dan-leo/thesis/README.md

# thesis
B.Eng (Hons) thesis, Stellenbosch University
