dan-leo/thesis/.latex/thesis.tex

% !TEX program = pdflatex
% !BIB program = biber

%% One can optionally have all this inside a separate setup.tex
\include{setup}

\title{Insert title here}
\author{Daniel Robinson\\18361137}

\pagenumbering{roman}
\setlength\parindent{0pt}

\begin{document}
% \maketitle
    \begin{titlepage}
        \begin{center}
            \vspace*{1cm}
            
            \begin{figure}
			\centering
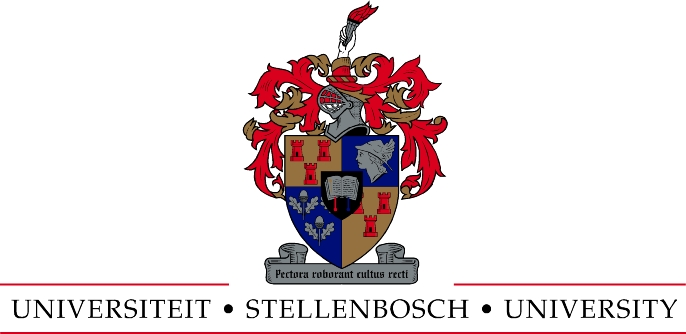
[picture p1: .latex/images/UScrest-top.jpg]
            
            \end{figure}
            
            \huge
            \textbf{Normalized Differential Vegetation Index Mapping}

            \large            
            \vspace{2.5cm}

            \textbf{Daniel Robinson\\18361137}

            \vspace{2.5cm}    
            
            \textbf{Report submitted in partial fulfilment of the requirements of the module Project (E) 448
            for the degree Baccalaureus in Engineering in the Department of Electrical and Electronic
            Engineering at the University of Stellenbosch}
            
            \vspace{4cm} 
            
            \textbf{STUDY LEADER: Corné van Daalen\\DATE: November 2017}

        \end{center}
\end{titlepage}

\setcounter{secnumdepth}{-2}% default for "report" is 2

\newpage
\chapter{Declaration of own work}

I, the undersigned, hereby declare that the work contained in this report is my own original work
unless indicated otherwise.

\vspace{2.5cm}   

Signature: \hrulefill

\hspace*{0mm}\phantom{Signature: }Daniel Robinson

\hspace*{0mm}\phantom{Signature: }BEng Electrical \& Electronic

\vspace{1cm}   

Date:\space\space\space\space\space\hrulefill

\chapter{Abstract}

This report presents the design and analysis necessary for an autonomous system to acquire beneficial agricultural data within a desired environment.\\

Various implementations are compared, before a novel design is presented.\\

An aerial drone is designed and built using predominantly local supplies. Images are acquired, calibrated, processed and mapped before an NDVI is performed. The system is quite capable and cost-effective compared to existing solutions. However, further investigation is required in mapping and NDVI calibration for consistency.

\chapter{Uitreksel}

Hierdie verslag toon die nodige ontwerp en ontleding aan om nuttige landbou data van 'n uitverkose omgewing deur middel van 'n selfbesturende sisteem te verkry.\\

Verskye toepassings is met mekaar vergelyk voordat 'n unieke ontwerp aangebied is.\\

'n Onbemande hommeltuig is ontwerp en gebou deur hoofsaaklik van plaaslike onderdele gebruik te maak. In die proses is foto's verkry, gekalibreer, verwerk en gekarteer voordat 'n genormaliseerde differensiële plantegroei indeks (GDPI) bereken is. Die stelsel is geskik en koste effektief in vergelyking met huidige komersiële oplossings.\\

Vir konsekwensie word verdere ondersoek egter in kartering en kalibrasie van die GDPI verlang.

\chapter{Acknowledgements}

I would like to thank the following people for their support:
\begin{itemize}
    \item Louw Hopley, for giving birth to the idea.
    \item Alan Knott-Craig, for introducing me to Chris Antoniesson, for we went on a flight test together which returned very useful data.
    \item My family, who have been amused and for their unwavering love and support.
    \item Dr Corné van Daalen, for his guidance and support throughout the course of this project.
\end{itemize}

%\frontmatter
\cleardoublepage
\tableofcontents

\clearpage
\label{listoffigures}
\addcontentsline{toc}{chapter}{\listfigurename}
\listoffigures

%\clearpage
%\addcontentsline{toc}{chapter}{\listtablename}
%\label{listoftables}
%\listoftables

%\chapter{List of Symbols}
%\begin{table}[H]
%\centering
%\begin{tabular}{l|r|r}
%Symbol & Description & Units\\\hline\\
%$F$ & Fundamenal Matrix & 3x3\\
%$R$ & Rotation Matrix & 3x3\\
%$T$ & Translation Matrix & 3x3\\
%\end{tabular}
%%\caption{\label{tab:symb}Table depicting list of symbols. (Will probably not have this caption)}
%\end{table}

\chapter{List of Abbreviations}
\begin{table}[H]
\centering
\begin{tabular}{l|r}
Abbreviation & Description \\\hline
UAV & Unmanned Aerial Vehicle \\
NDVI & Normalised Differential Vegetation Index\\
IR & Infra Red\\
PAR & Photosynthetically Active Radiation\\
PCB & Printed Circuit Board\\
CSI & Camera Serial Interface\\
SBUS & Serial Bus\\
GPIO & General Purpose In Out\\
LUT & Look Up Table\\
FHSS & Frequency Hopping Spread Spectrum\\
NLOS & Non Line of Sight\\
SDR & Software Defined Radio\\
GPS & Global Positioning System\\
MME & Maps Made Easy\\
RGB & Red Green Blue\\
NIR & Near Infra Red\\
ESC & Electronic Speed Controller\\
PPM & Pulse Position Modulation\\
ISM & Industrial Scientific Medical\\
IMU & Inertial Measurement Unit\\
SMA & SubMiniature version A\\
GCS & Ground Control Station\\
PWM & Pulse Width Modulation\\
SDR & Software Defined Radio\\
NTP & Network Time Protocol\\

\end{tabular}
%\caption{\label{tab:abbr}Table depicting list of abbreviations. (Will probably not have this caption)}
\end{table}

%\chapter{Matrix Notation}
%
%(Still to be expanded on).

\setcounter{secnumdepth}{2}

\include{chapter1}
\label{chapter:intro}
\include{chapter2}
\label{chapter:literature}
\include{chapter3}
\include{chapter4}
\include{chapter5}
\include{chapter6}

\chapter{Conclusion}

Overall, the system seems capable. It is much cheaper than equivalent products on the market today, and would require some refining to be robust, and consistently useful for farmers.\\

The drone design and construction, image acquisition, stereo rectification and calibration was a success, but the mapping and NDVI calibration will need some further investigation.\\

With further investigation, it can be determined whether farmers are applying water, fertilizer and pesticides uniformly, and the effects of other environmental factors.\\

% In order for the data to be transmitted successfully, it needs to be in a format acceptable by the GCS. The data will be stored in a JSON packet created using a C++ library\cite{ajson}.

% Code block \ref{code:json1} shows a potential data packet.

% \lstset{language=html,caption={Potential packet},label=code:json1}
% \begin{lstlisting}
% {
%   "temperature": "11.3",
%   "pressure": "99.325"
% }
% \end{lstlisting}

% \begin{figure}
% \centering
% \includegraphics[scale=0.35]{flight_path.png}
% \caption{CanSat flight trajectory\\
% Reproduced from \cite{gopher}}
% \label{fig:flight_path}
% \end{figure}

% \subsection{How to add Tables}

% Use the table and tabular commands for basic tables --- see Table~\ref{tab:widgets}, for example. 

% \begin{table}
% \centering
% \begin{tabular}{l|r}
% Item & Quantity \\\hline
% Widgets & 42 \\
% Gadgets & 13
% \end{tabular}
% \caption{\label{tab:widgets}An example table.}
% \end{table}

% \subsection{How to write Mathematics}

% \LaTeX{} is great at typesetting mathematics. Let $X_1, X_2, \ldots, X_n$ be a sequence of independent and identically distributed random variables with $\text{E}[X_i] = \mu$ and $\text{Var}[X_i] = \sigma^2 < \infty$, and let
% \[S_n = \frac{X_1 + X_2 + \cdots + X_n}{n}
%       = \frac{1}{n}\sum_{i}^{n} X_i\]
% denote their mean. Then as $n$ approaches infinity, the random variables $\sqrt{n}(S_n - \mu)$ converge in distribution to a normal $\mathcal{N}(0, \sigma^2)$.

% \subsection{How to create Sections and Subsections}

% Use section and subsections to organize your document. Simply use the section and subsection buttons in the toolbar to create them, and we'll handle all the formatting and numbering automatically.

% \subsection{How to add Lists}

% You can make lists with automatic numbering \dots

% \begin{enumerate}
% \item Like this,
% \item and like this.
% \end{enumerate}
% \dots or bullet points \dots
% \begin{itemize}
% \item Like this,
% \item and like this.
% \end{itemize}

% \subsection{How to add Citations and a References List}

% You can upload a \verb|.bib| file containing your BibTeX entries, created with JabRef; or import your \href{https://www.overleaf.com/blog/184}{Mendeley}, CiteULike or Zotero library as a \verb|.bib| file. You can then cite entries from it, like this: \cite{greenwade93}. Just remember to specify a bibliography style, as well as the filename of the \verb|.bib|.

% You can find a \href{https://www.overleaf.com/help/97-how-to-include-a-bibliography-using-bibtex}{video tutorial here} to learn more about BibTeX.

% We hope you find Overleaf useful, and please let us know if you have any feedback using the help menu above --- or use the contact form at \url{https://www.overleaf.com/contact}!

\include{appendices}

\newpage
\bibliographystyle{plain}
%\bibliographystyle{alpha}
\bibliography{references}

%@misc{gopher,
%	author = {Garden City Collegiate Space Agency},
%    title = {GOPHER SPACE},
%    month = feb,
%    year = {2017},
%    howpublished={\url{http://gopherspace.pbworks.com/w/page/93541286/GOPHER%20SPACE}}
%}
%
%@article{greenwade93,
%    author  = "George D. Greenwade",
%    title   = "The {C}omprehensive {T}ex {A}rchive {N}etwork ({CTAN})",
%    year    = "1993",
%    journal = "TUGBoat",
%    volume  = "14",
%    number  = "3",
%    pages   = "342--351"
%}

\end{document}
