dan-leo/thesis/.latex/main.tex

% !TEX program = pdflatex
% !BIB program = biber

%% One can optionally have all this inside a separate setup.tex
\include{setup}

\title{Insert title here}
\author{Daniel Robinson\\18361137}

\begin{document}
% \maketitle
    \begin{titlepage}
        \begin{center}
            \vspace*{1cm}
            
            \begin{figure}
			\centering
            
            \end{figure}
            
            \huge
            \textbf{Insert title here\\Sub-title}
            
            \vspace{1.5cm}
            
            \large
            \vspace{2.5cm}
            Daniel Robinson\\
            18361137\\
            \vspace{4.5cm}
            
            \large
            Date: 7 February 2017
            
        \end{center}
\end{titlepage}

\tableofcontents
\listoffigures
\listoftables

\newpage

% \begin{abstract}
% Your abstract.
% \end{abstract}

\section{Systems Overview}

In this section the mission objectives and requirements are specified.

\subsection{Mission Objectives}
In order to be deemed successful the CanSat system needs to complete the following missions:

\begin{itemize}
    \item The CanSat will be launched from approximately 1000m by a rocket.  The CanSat will then be ejected from the rocket.
    \item Measurements of air pressure and temperature will be taken during decent.
    \item These measurements will be transmitted at least once every second to the ground station.
    \item On the ground station the received data will be analysed.
\end{itemize}

% \begin{figure}[H]
% \begin{subfigure}{0.5\textwidth}
% \includegraphics[scale=0.3]{3.png}
% \caption{Pushbutton Switch.\\
% Reproduced from \cite{cpi}.}
% \label{fig:p}
% \end{subfigure}
% \begin{subfigure}{0.5\textwidth}
% \centering
% \includegraphics[scale=0.1]{2.png}
% \caption{InvenSense MPU-9250.\\
% Reproduced from\cite{iven}.}
% \label{fig:att}
% \end{subfigure}
% \begin{subfigure}{0.5\textwidth}
% \centering
% \includegraphics[scale=0.3]{1.png}
% \caption{Altimeter Module MS5607.\\ Reproduced from \cite{par}.}
% \label{fig:pres}
% \end{subfigure}
% \caption{Sensors}
% \label{fig:sensors}
% \end{figure}

% In order for the data to be transmitted successfully, it needs to be in a format acceptable by the GCS. The data will be stored in a JSON packet created using a C++ library\cite{ajson}.

% Code block \ref{code:json1} shows a potential data packet.

% \lstset{language=html,caption={Potential packet},label=code:json1}
% \begin{lstlisting}
% {
%   "temperature": "11.3",
%   "pressure": "99.325"
% }
% \end{lstlisting}

% \begin{figure}
% \centering
% \includegraphics[scale=0.35]{flight_path.png}
% \caption{CanSat flight trajectory\\
% Reproduced from \cite{gopher}}
% \label{fig:flight_path}
% \end{figure}

% \subsection{How to add Tables}

% Use the table and tabular commands for basic tables --- see Table~\ref{tab:widgets}, for example. 

% \begin{table}
% \centering
% \begin{tabular}{l|r}
% Item & Quantity \\\hline
% Widgets & 42 \\
% Gadgets & 13
% \end{tabular}
% \caption{\label{tab:widgets}An example table.}
% \end{table}

% \subsection{How to write Mathematics}

% \LaTeX{} is great at typesetting mathematics. Let $X_1, X_2, \ldots, X_n$ be a sequence of independent and identically distributed random variables with $\text{E}[X_i] = \mu$ and $\text{Var}[X_i] = \sigma^2 < \infty$, and let
% \[S_n = \frac{X_1 + X_2 + \cdots + X_n}{n}
%       = \frac{1}{n}\sum_{i}^{n} X_i\]
% denote their mean. Then as $n$ approaches infinity, the random variables $\sqrt{n}(S_n - \mu)$ converge in distribution to a normal $\mathcal{N}(0, \sigma^2)$.

% \subsection{How to create Sections and Subsections}

% Use section and subsections to organize your document. Simply use the section and subsection buttons in the toolbar to create them, and we'll handle all the formatting and numbering automatically.

% \subsection{How to add Lists}

% You can make lists with automatic numbering \dots

% \begin{enumerate}
% \item Like this,
% \item and like this.
% \end{enumerate}
% \dots or bullet points \dots
% \begin{itemize}
% \item Like this,
% \item and like this.
% \end{itemize}

% \subsection{How to add Citations and a References List}

% You can upload a \verb|.bib| file containing your BibTeX entries, created with JabRef; or import your \href{https://www.overleaf.com/blog/184}{Mendeley}, CiteULike or Zotero library as a \verb|.bib| file. You can then cite entries from it, like this: \cite{greenwade93}. Just remember to specify a bibliography style, as well as the filename of the \verb|.bib|.

% You can find a \href{https://www.overleaf.com/help/97-how-to-include-a-bibliography-using-bibtex}{video tutorial here} to learn more about BibTeX.

% We hope you find Overleaf useful, and please let us know if you have any feedback using the help menu above --- or use the contact form at \url{https://www.overleaf.com/contact}!

\newpage
\bibliographystyle{plain}
% \bibliographystyle{alpha}
\bibliography{references}

\end{document}
