dan-leo/thesis/.latex/images/base_eagle.JPG

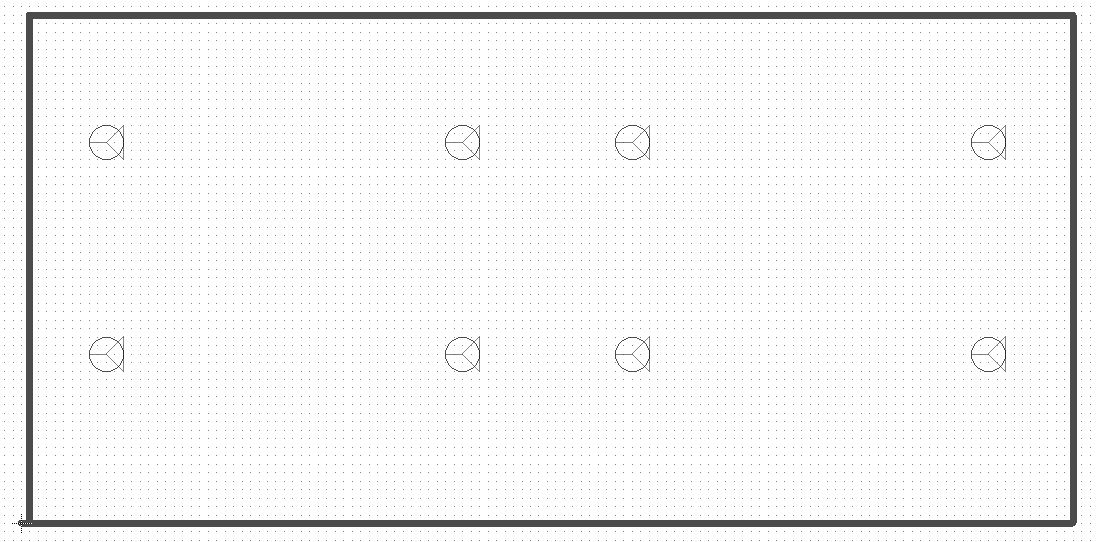
.latex/images/base_eagle.JPG
