dan-leo/thesis/.latex/images/distortion_flir2.JPG

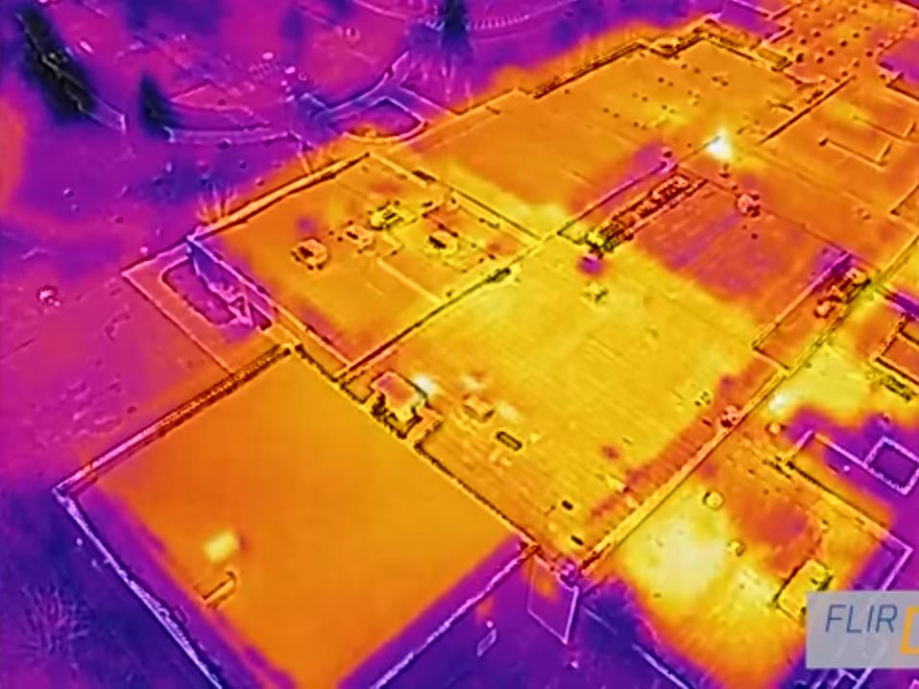
.latex/images/distortion_flir2.JPG
