dan-leo/thesis/.latex/images/distortion_flir.JPG

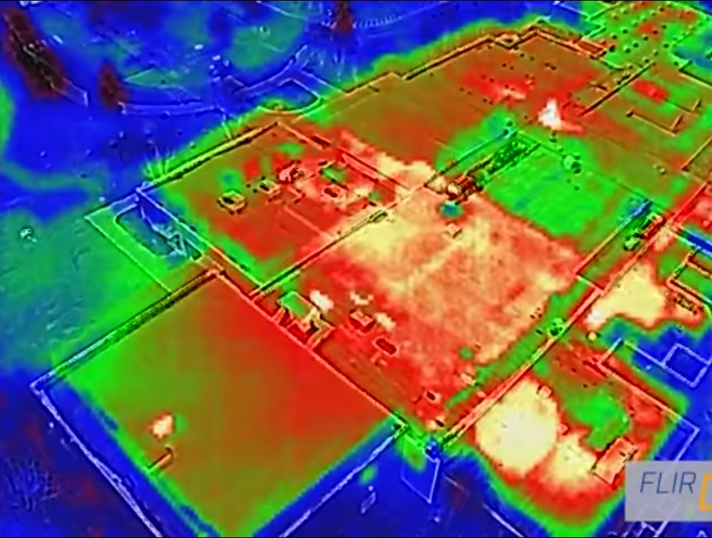
.latex/images/distortion_flir.JPG
