dan-leo/thesis/.latex/images/hex.JPG

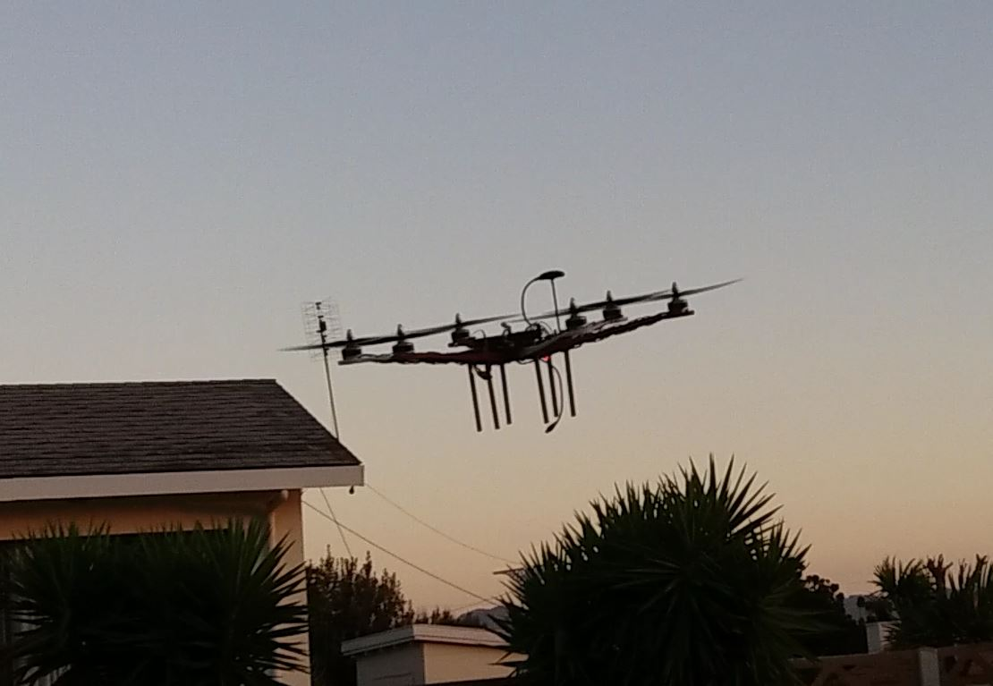
.latex/images/hex.JPG
