dan-leo/thesis/.latex/images/lcd/20171028_095547.jpg

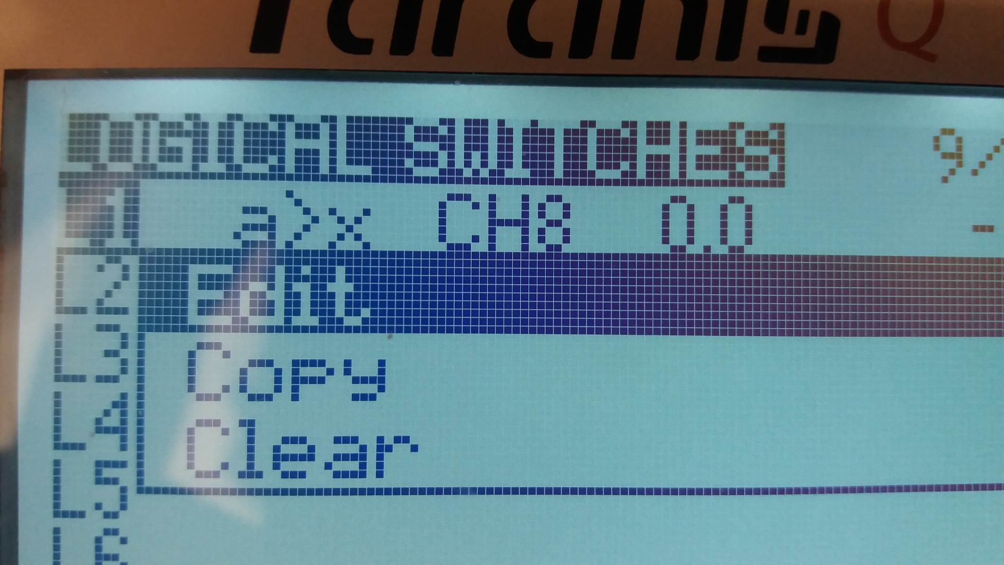
.latex/images/lcd/20171028_095547.jpg
