dan-leo/thesis/.latex/images/lcd/20171028_095605.jpg

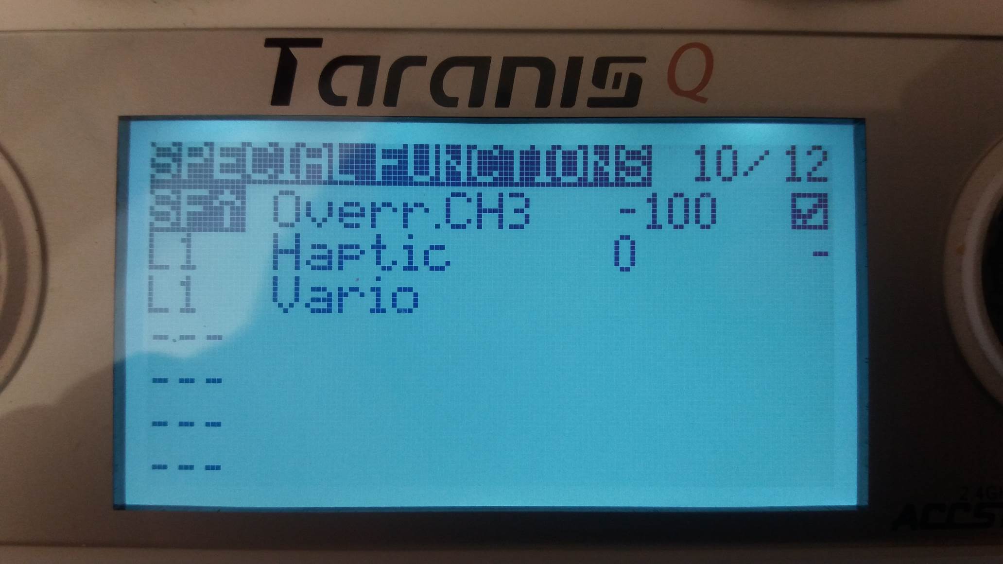
.latex/images/lcd/20171028_095605.jpg
