dan-leo/thesis/.latex/images/lcd/firmware.jpg

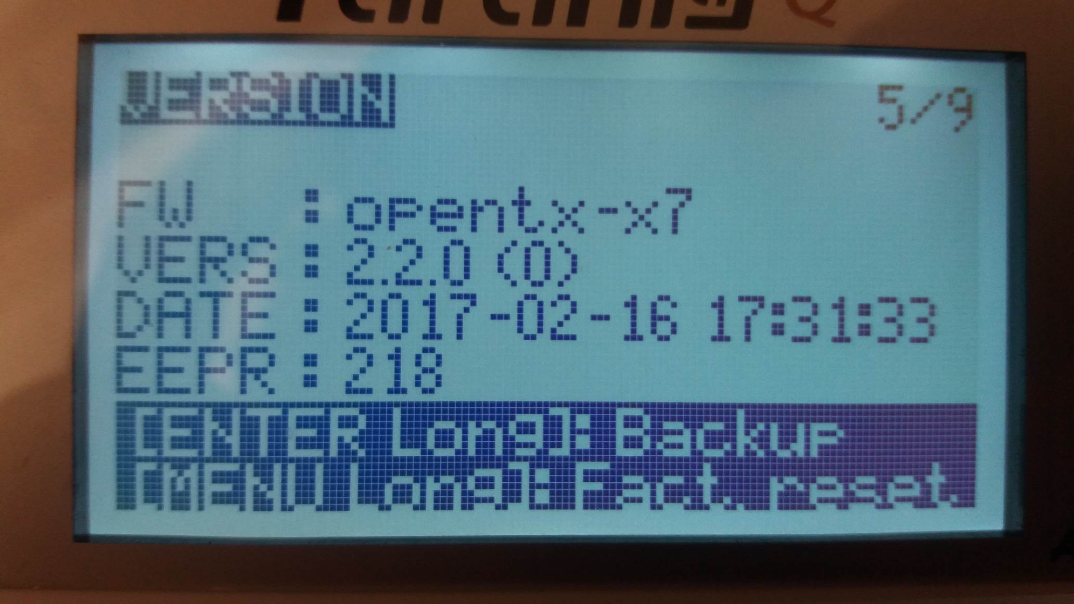
.latex/images/lcd/firmware.jpg
