dan-leo/thesis/.latex/images/lcd/mixer2.jpg

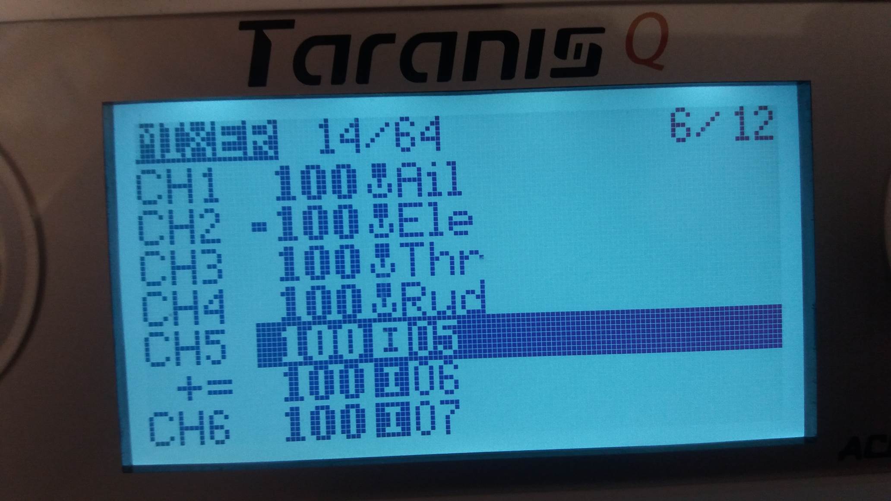
.latex/images/lcd/mixer2.jpg
