dan-leo/thesis/.latex/images/lcd/telemetry2.jpg

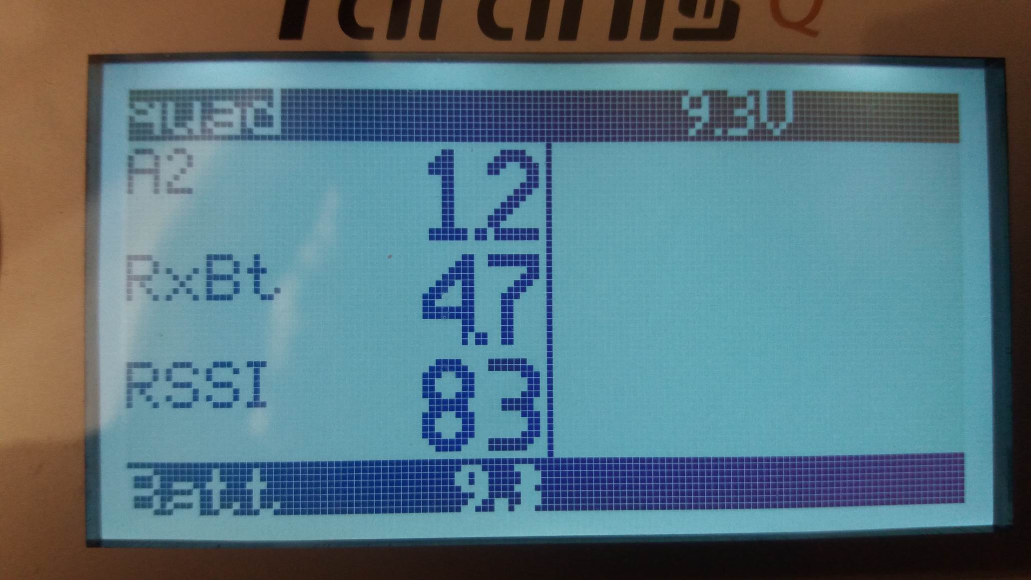
.latex/images/lcd/telemetry2.jpg
