dan-leo/thesis/.latex/images/ndvi_stitch_example.jpg

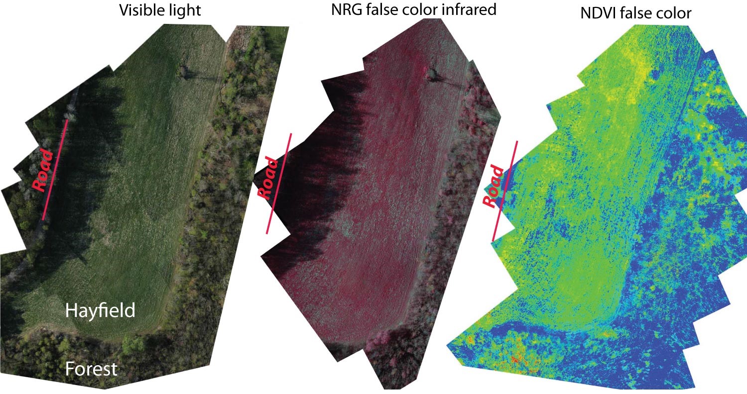
.latex/images/ndvi_stitch_example.jpg
