dan-leo/thesis/.latex/images/temp2/433_comms.PNG

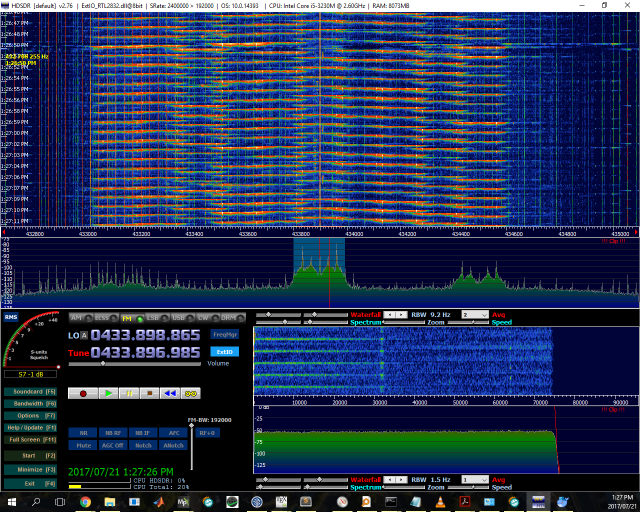
.latex/images/temp2/433_comms.PNG
