dan-leo/thesis/.latex/images/temp2/20170922_204751.jpg

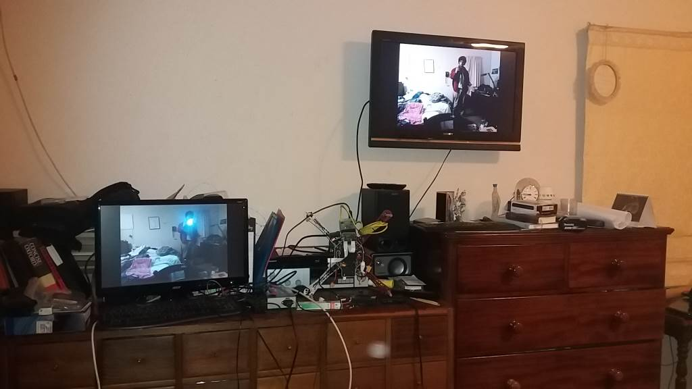
.latex/images/temp2/20170922_204751.jpg
