dan-leo/thesis/.latex/images/temp2/20171028_115440.jpg

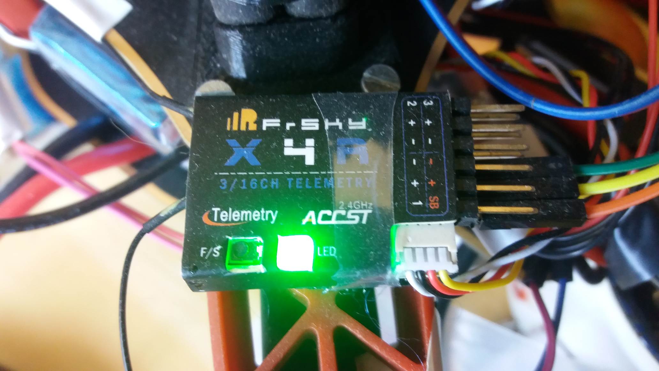
.latex/images/temp2/20171028_115440.jpg
