dan-leo/thesis/.latex/images/temp2/20171029_143333.jpg

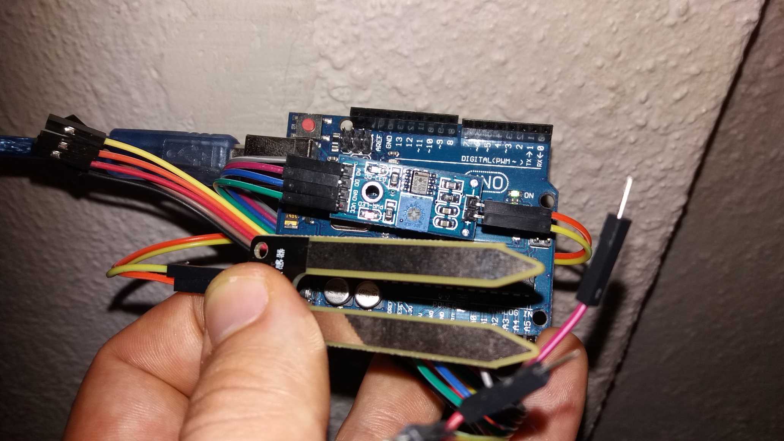
.latex/images/temp2/20171029_143333.jpg
