dan-leo/thesis/.latex/images/temp2/20171029_143347.jpg

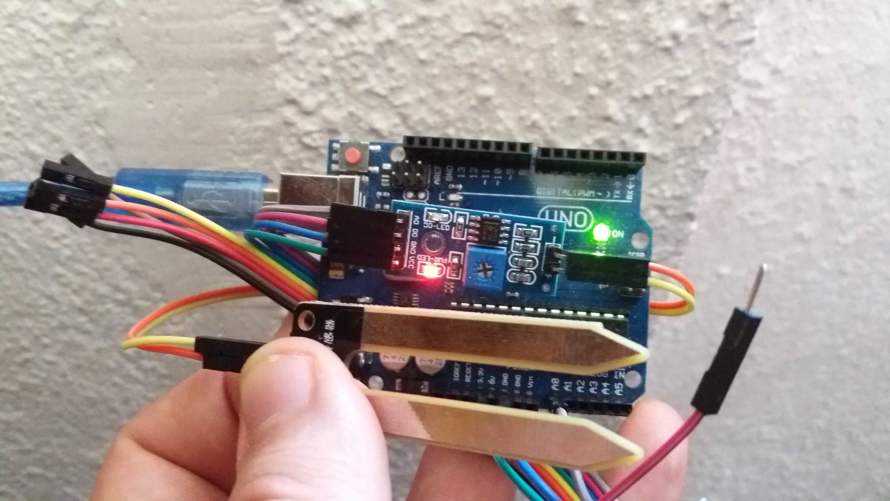
.latex/images/temp2/20171029_143347.jpg
