dan-leo/thesis/.latex/images/temp2/aluminium.jpg

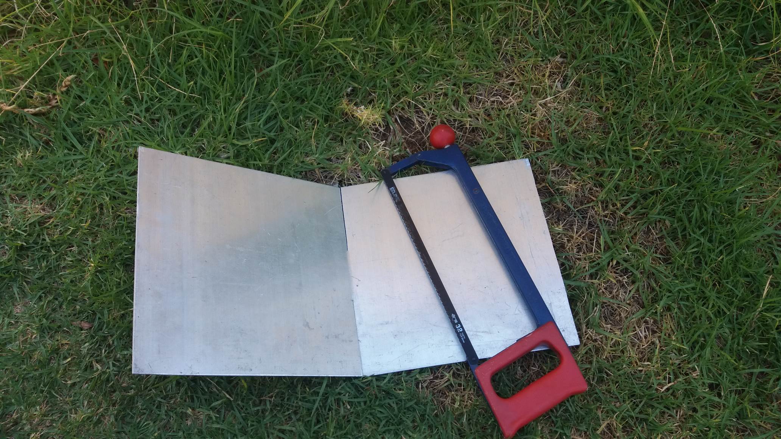
.latex/images/temp2/aluminium.jpg
