dan-leo/thesis/.latex/images/temp2/comp_mot_true_current.PNG

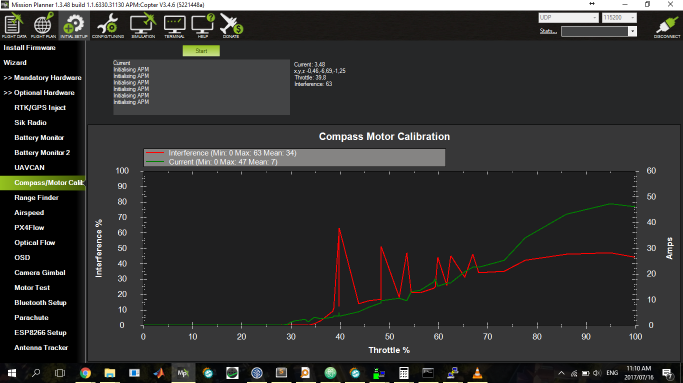
.latex/images/temp2/comp_mot_true_current.PNG
