dan-leo/thesis/.latex/images/temp2/flight_modes.JPG

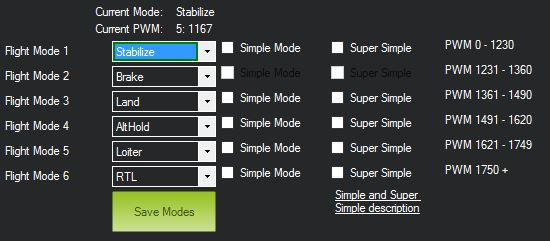
.latex/images/temp2/flight_modes.JPG
