dan-leo/thesis/.latex/images/temp2/longridgeir20171029.jpg

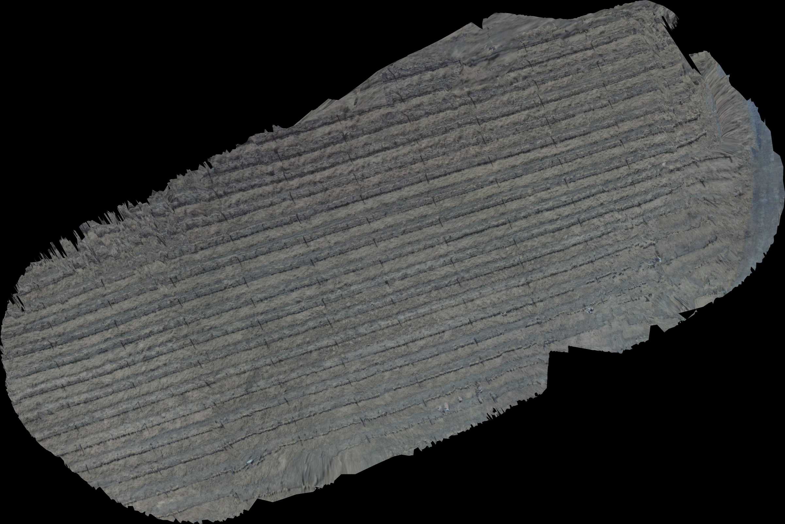
.latex/images/temp2/longridgeir20171029.jpg
