dan-leo/thesis/.latex/images/temp2/longridgergb20171029.jpg

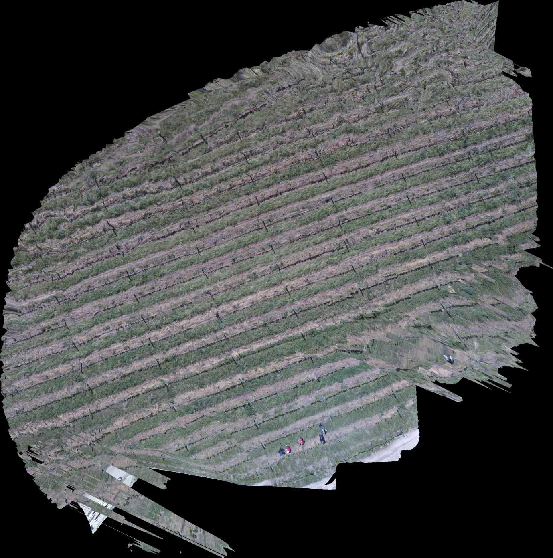
.latex/images/temp2/longridgergb20171029.jpg
