dan-leo/thesis/.latex/images/temp2/map_ndvi.jpg

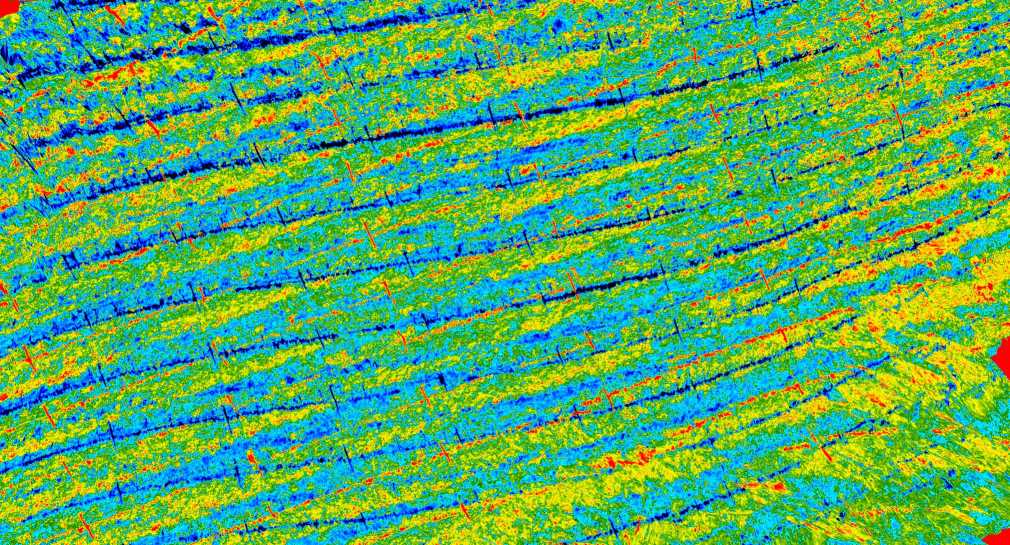
.latex/images/temp2/map_ndvi.jpg
