dan-leo/thesis/.latex/images/temp2/plane.jpg

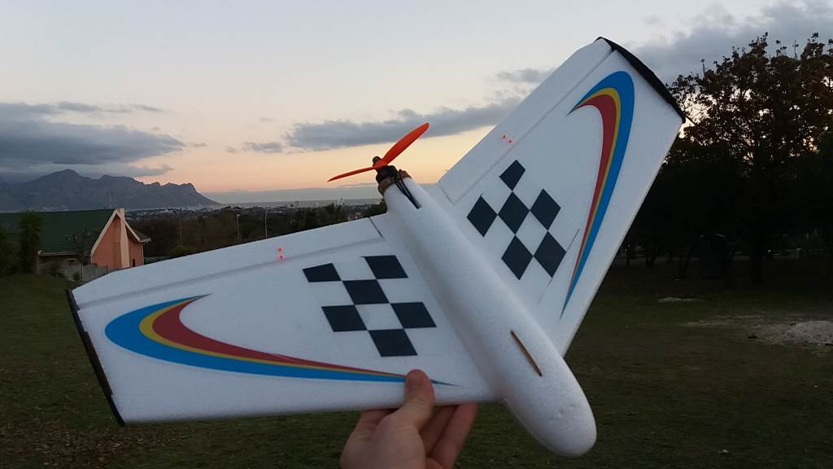
.latex/images/temp2/plane.jpg
