dan-leo/thesis/.latex/images/temp2/rgb2016-12-28-173739-147.jpg

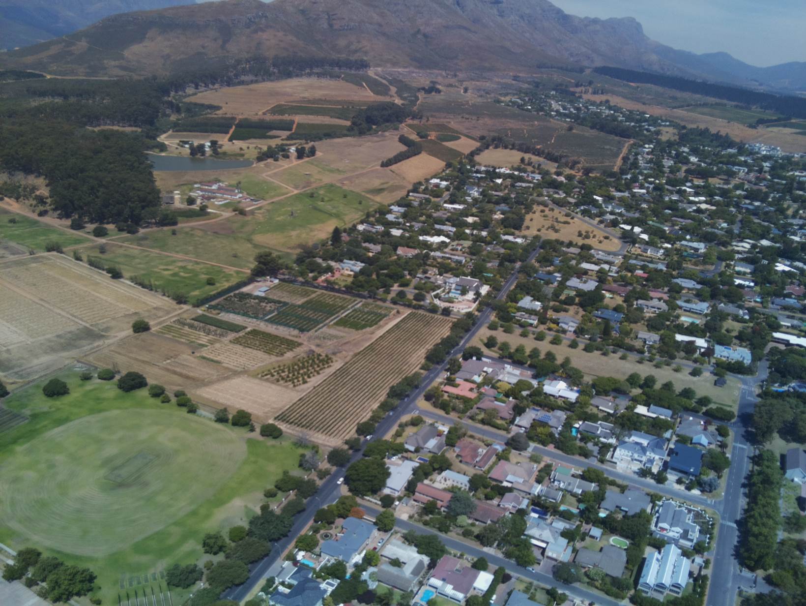
.latex/images/temp2/rgb2016-12-28-173739-147.jpg
