dan-leo/thesis/.latex/images/thesis_overview.png

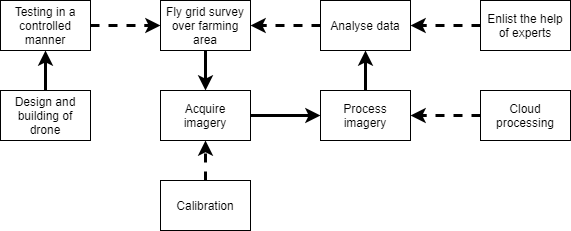
.latex/images/thesis_overview.png
