dan-leo/thesis/.latex/setup.tex

% !TEX program = pdflatex
% !BIB program = biber

% !TEX root = main.tex
\documentclass[12pt, a4paper]{report}
% \documentclass[12pt, a4paper, oneside]{memoir}
% \chapterstyle{veelo}

%% Sets page size and margins
\usepackage[a4paper,top=2.5cm,bottom=2cm,left=3cm,right=2cm,marginparwidth=1.75cm]{geometry}
%\usepackage[left=2cm,top=2cm,bottom=2cm,bindingoffset=1cm]{geometry}

\usepackage[utf8x]{inputenc}
\usepackage{graphicx}
\usepackage{float}
\usepackage{imakeidx}
\usepackage{amsmath}
\usepackage[colorlinks=true, allcolors=blue]{hyperref}
\usepackage{graphicx}
\usepackage{float}
\usepackage{imakeidx}
\usepackage{amsmath}
\usepackage{url}
\usepackage[export]{adjustbox}
\usepackage{subcaption}
\usepackage[toc,page]{appendix}
\usepackage{amsmath}
%\usepackage{nccmath}

%% Useful packages
\usepackage[colorinlistoftodos]{todonotes}
\usepackage[T1]{fontenc}

%% Language and font encodings
\usepackage[english]{babel}

%% Define a few colours to be used throughout the document
\usepackage{tikz,xcolor}
\definecolor{TextColor}{HTML}{000000}
\definecolor{SideColorDark}{HTML}{000000}
\definecolor{MainColor}{HTML}{0000FF}
\definecolor{OppositeColor}{HTML}{FF0000}
\definecolor{HighlightColor}{HTML}{FFFF00}

%% Code block style
%  Load the \ttfamily font
\usepackage[T1]{fontenc}
\usepackage[scaled]{beramono}

%  Format code blocks
\usepackage{listings}
%  Change caption name
\renewcommand*{\lstlistingname}{Code block}
\captionsetup[lstlisting]{margin=0cm,format=hang,font=small,format=plain,labelfont={bf,up},textfont={it}}
%  Style
\lstset{
  showstringspaces=false,
  formfeed=\newpage,
  commentstyle=\itshape,
  backgroundcolor=\color{gray!5},
  breakatwhitespace=false,         % sets if automatic breaks should only happen at whitespace
  breaklines=true,                 % sets automatic line breaking
  captionpos=b,                    % sets the caption-position to bottom
  commentstyle=\color{gray},    % comment style
  escapeinside={\%*}{*)},          % if you want to add LaTeX within your code
  keepspaces=true,
  numbersep=2mm,                   % how far the line-numbers are from the code
  showspaces=false,
  showstringspaces=false,
  showtabs=false,
  stepnumber=1, numberfirstline=false,
  basicstyle=\linespread{1}\footnotesize\ttfamily,
  keywordstyle=\bfseries\color{MainColor},
  stringstyle=\itshape\color{OppositeColor},
  numberstyle=\footnotesize\ttfamily\color{gray},
  numbers=left,xleftmargin=4mm,framexleftmargin=0mm,xrightmargin=0mm,
  frame=top,frame=bottom,
}

%\linespread{1}
