dan-leo/thesis/.latex/images/drone-build-3dcase-ribbon.jpg

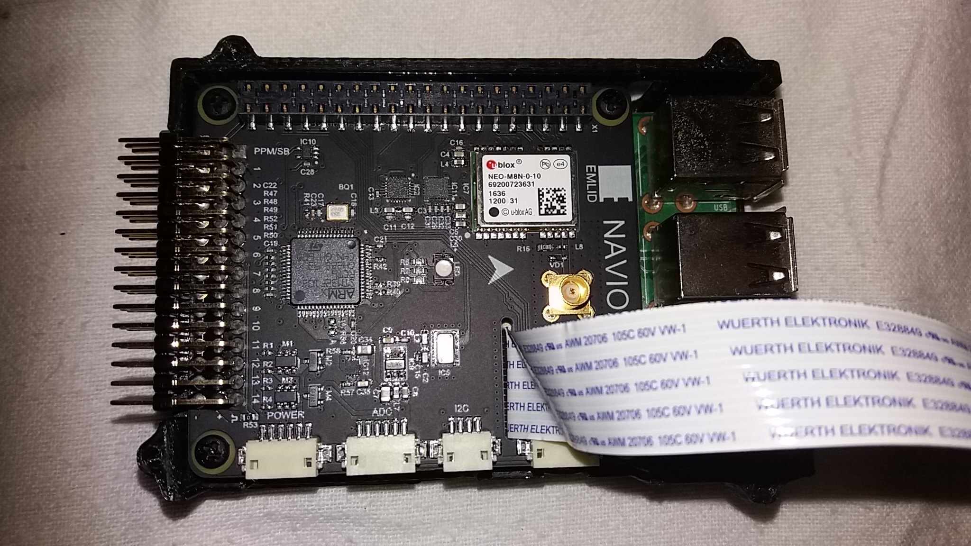
.latex/images/drone-build-3dcase-ribbon.jpg
