dan-leo/thesis/current_calibration.md

Voltage constant = 10.872

26A; 0.5 ohm; const: 220, 684. 

According to sample 2: 16.9625A, 17.723A. 
Therefore, 15.09 / 17.723 makes 0,85 ohm.

A0: 5.3100V A1: 0.0200V A2: 1.4760V A3: 0.0000V A4: 0.0000V A5: 1.4740V
A0: 5.3100V A1: 0.0200V A2: 1.4760V A3: 0.0000V A4: 0.0000V A5: 1.4800V
A0: 5.3100V A1: 0.0240V A2: 1.4780V A3: 0.0000V A4: 0.0000V A5: 1.4820V
A0: 5.3100V A1: 0.0240V A2: 1.4740V A3: 0.0000V A4: 0.0000V A5: 1.4780V
A0: 5.3160V A1: 0.0240V A2: 1.4020V A3: 0.1220V A4: 0.0380V A5: 1.3720V
A0: 5.3220V A1: 0.0200V A2: 1.3940V A3: 0.1160V A4: 0.0360V A5: 1.3680V
A0: 5.3180V A1: 0.0240V A2: 1.3880V A3: 0.1180V A4: 0.0380V A5: 1.3600V
A0: 5.3060V A1: 0.0260V A2: 1.4560V A3: 0.0000V A4: 0.0000V A5: 1.4520V
A0: 5.3100V A1: 0.0240V A2: 1.4580V A3: 0.0000V A4: 0.0000V A5: 1.4620V
A0: 5.3100V A1: 0.0240V A2: 1.4620V A3: 0.0000V A4: 0.0000V A5: 1.4580V
A0: 5.3100V A1: 0.0240V A2: 1.4600V A3: 0.0000V A4: 0.0000V A5: 1.4640V
A0: 5.3100V A1: 0.0260V A2: 1.4600V A3: 0.0000V A4: 0.0000V A5: 1.4620V

5.8 - 5.7A; 2.2 ohm; const: 143.75, 479

A0: 5.3100V A1: 0.0240V A2: 1.4580V A3: 0.0000V A4: 0.0000V A5: 1.4540V
A0: 5.3100V A1: 0.0240V A2: 1.4560V A3: 0.0000V A4: 0.0000V A5: 1.4540V
A0: 5.3100V A1: 0.0240V A2: 1.4580V A3: 0.0000V A4: 0.0000V A5: 1.4580V
A0: 5.3100V A1: 0.0240V A2: 1.4580V A3: 0.0000V A4: 0.0000V A5: 1.4580V
A0: 5.3040V A1: 0.0260V A2: 1.4260V A3: 0.0400V A4: 0.0120V A5: 1.4160V
A0: 5.3000V A1: 0.0260V A2: 1.4280V A3: 0.0380V A4: 0.0140V A5: 1.4140V
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
A0: 5.3020V A1: 0.0200V A2: 1.3960V A3: 0.0400V A4: 0.0120V A5: 1.3880V
A0: 5.3040V A1: 0.0200V A2: 1.3980V A3: 0.0400V A4: 0.0120V A5: 1.3860V
A0: 5.3020V A1: 0.0240V A2: 1.3960V A3: 0.0400V A4: 0.0120V A5: 1.3860V
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

Final: 145, 460
