dan-leo/thesis/.latex/images/temp2/tuning.PNG

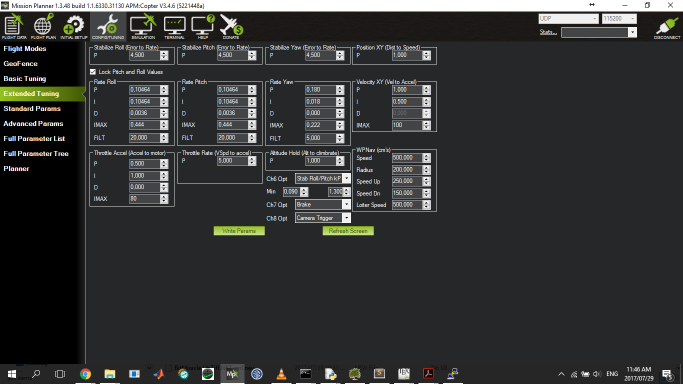
.latex/images/temp2/tuning.PNG
