dan-leo/thesis/todo.md

synchronise time between cameras
synchronise system time
audio feedback when taking photo to handheld transceiver
link photos to gps coordinates
correlate gps position with gps data more accurately
pause when taking photo
rebuild source code for arducopter, mission planner, ImageJ
increase channels to listen to within dronekit (from 8)
filter specific log messages
auto-tune
remove shadows, if possible
investigate why gps spotty
DONE -> make space on external harddrive for images
transfer images over ethernet
ntp client server http://raspberrypi.tomasgreno.cz/ntp-client-and-server.html
DONE -> use IntelliJ idea
DONE -> trigger consequent photos simultaneously
DONE -> lower cpu usage of mavproxy.py
DONE -> reconnect to GCS https://unix.stackexchange.com/questions/128439/good-detailed-explanation-of-etc-network-interfaces-syntax
DONE -> trigger camera from handheld transceiver
DONE -> ssh-keys
DONE -> python > ethernet > python  (via socket)
DONE -> trigger infra-red camera simultaneously.
DONE -> on boot {wifi, mavlink, camera}
DONE -> file names not jumbled
DONE -> listen for camera trigger https://community.emlid.com/t/raspivid-camera-trigger-and-raspistill/6573/3
DONE -> remove heartbeat messages from mission planner
DONE -> extend ribbon cable http://za.rs-online.com/web/c/cables-wires/ribbon-flat-cable/ffc-fpc-jumper-cables/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\
DONE -> wifi reconnect https://tech.scargill.net/pi-zero-wi-fi-automatic-reconnect  https://www.raspberrypi.org/forums/viewtopic.php?t=16054  http://weworkweplay.com/play/automatically-connect-a-raspberry-pi-to-a-wifi-network/  http://alexba.in/blog/2015/01/14/automatically-reconnecting-wifi-on-a-raspberrypi/
DONE -> wifi priority https://raspberrypi.stackexchange.com/questions/58304/how-to-set-wifi-network-priority
