dan-leo/thesis/.sloeber/moisture_sensor/.ino.cpp

#ifdef __IN_ECLIPSE__
//This is a automatic generated file
//Please do not modify this file
//If you touch this file your change will be overwritten during the next build
//This file has been generated on 2017-08-30 20:03:57

#include "Arduino.h"
#include "Arduino.h"
#include <Wire.h>
void setup() ;
void loop() ;
int convertToPercent(int value)                     ;
void printValuesToSerial()                           ;

#include "moisture_sensor.ino"


#endif
