dan-leo/thesis/(commit log)

2017-07-17 added pi config for arducopter, log analyzer, current calibration data for power modules
2017-09-30 {comms, moisture sensor, latex, opencv C++ source build}
2017-10-05 single image calibration workflow
